Levi-Holscher/Robotics_Worship_Project/firmware/Praise the Lord.ioc

Mcu.UserName=STM32F446RETx
PA0-WKUP.GPIO_Label=M1_CURR_AMPL_U
PA0-WKUP.Signal=ADCx_IN0
PA1.GPIO_Label=M1_BUS_VOLTAGE
PA1.Signal=ADCx_IN1
PA10.GPIO_Label=M1_PWM_WH
PA10.Signal=S_TIM1_CH3
PA15.GPIO_Label=M1_ENCODER_A
PA15.Signal=S_TIM2_CH1_ETR
PA2.GPIO_Label=UART_TX
PA2.Signal=USART2_TX
PA3.GPIO_Label=UART_RX
PA3.Signal=USART2_RX
PA6.GPIO_Label=M1_OCP
PA6.Signal=TIM1_BKIN
PA7.GPIO_Label=M1_PWM_UL
PA7.Signal=TIM1_CH1N
PA8.GPIO_Label=M1_PWM_UH
PA8.Signal=S_TIM1_CH1
PA9.GPIO_Label=M1_PWM_VH
PA9.Signal=S_TIM1_CH2
PB0.GPIO_Label=M1_PWM_VL
PB0.Signal=TIM1_CH2N
PB1.GPIO_Label=M1_PWM_WL
PB1.Signal=TIM1_CH3N
PB10.GPIO_Label=limit_switch_power
PB10.Signal=GPIO_Output
PB3.GPIO_Label=M1_ENCODER_B
PB3.Signal=S_TIM2_CH2
PB4.GPIO_Label=center_toggle_out
PB4.Signal=GPIO_Input
PB5.GPIO_Label=center_toggle_in
PB5.Signal=GPIO_Input
PB6.GPIO_Label=theta2_encoder_A
PB6.Signal=S_TIM4_CH1
PB7.GPIO_Label=theta2_encoder_B
PB7.Signal=S_TIM4_CH2
PB8.GPIO_Label=yellow_light
PB8.Signal=GPIO_Output
PC0.GPIO_Label=M1_CURR_AMPL_W
PC0.Signal=ADCx_IN10
PC1.GPIO_Label=M1_CURR_AMPL_V
PC1.Signal=ADCx_IN11
PC10.GPIO_Label=edge_toggle_in
PC10.Signal=GPIO_Input
PC11.GPIO_Label=edge_toggle_out
PC11.Signal=GPIO_Input
PC12.GPIO_Label=limit_switch
PC12.Signal=GPIO_Input
PC2.GPIO_Label=M1_TEMPERATURE
PC2.Signal=ADCx_IN12
PC5.GPIO_Label=red_light
PC5.Signal=GPIO_Output
PC6.GPIO_Label=theta1_encoder_A
PC6.Signal=S_TIM3_CH1
PC7.GPIO_Label=theta1_encoder_B
PC7.Signal=S_TIM3_CH2
PC8.GPIO_Label=white_light
PC8.Signal=GPIO_Output
PC9.GPIO_Label=green_light
PC9.Signal=GPIO_Output
PH0-OSC_IN.Signal=RCC_OSC_IN
PH1-OSC_OUT.Signal=RCC_OSC_OUT
